TauheedAlamgir/Autonomous-Snowplow/README.md

# Autonomous Snowplow Robot
Project for SYSC 4805 – Carleton University

Overview:
This project focuses on developing an autonomous snowplow robot that detects obstacles, follows boundaries, and clears cube-shaped objects simulating snow. It combines sensor integration, movement control, and real-time communication using Arduino microcontrollers.

Features:
- Obstacle detection (Ultrasonic, ToF sensors)
- Line following using IR sensors
- PID-based movement control
- Custom 3D-printed plow design
- Integrated testing for speed, navigation, and obstacle avoidance

Hardware & Software:
- Microcontrollers: Arduino DUE, Arduino Nano Every
- Sensors: Ultrasonic, ToF, IMU, Line Follower
- Language: C/C++ (Arduino)
- Tools: AutoCAD, Arduino IDE

Files:

         SYSC4805_L3_Project_Proposal_Group5.pdf   – Project proposal
  
         SYSC4805_L3_ProgressReport_Group5-2.pdf   – Progress report
  
         SYSC4805_L3_FinalReport_Group5.pdf        – Final report
  
         PlowDesign1.jpg / PlowDesign2.jpg / PlowDesign3.jpg – CAD plow designs
  
         PlowDimensions.pdf                         – Plow dimensions
  
         VMA330UnitTest.ino                         – Obstacle detection test
  
         line_follower.cpp                          – Line-following algorithm

Team Members:
  Ahmed Ali, Brendan Kennedy, Duncan MacLeod, Tauheed Alamgir
