TauheedAlamgir/Autonomous-Snowplow/PlowDesign2.jpg

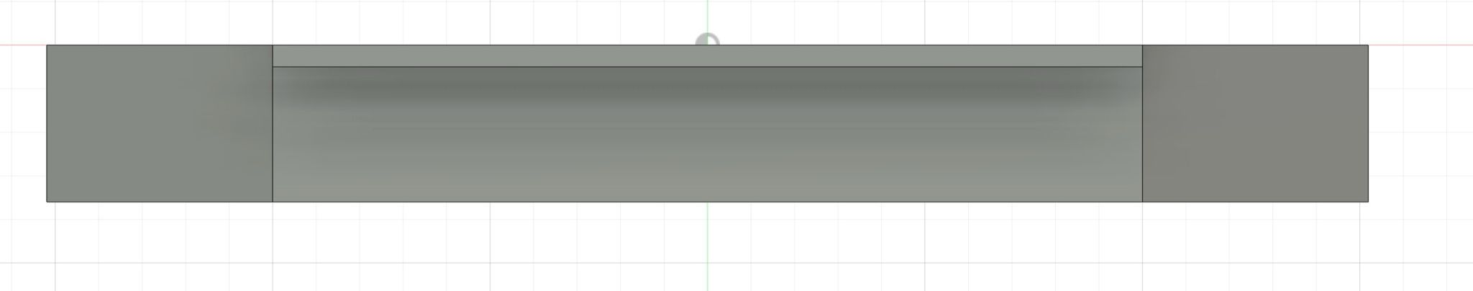
PlowDesign2.jpg
