TauheedAlamgir/Autonomous-Snowplow/PlowDimensions.pdf

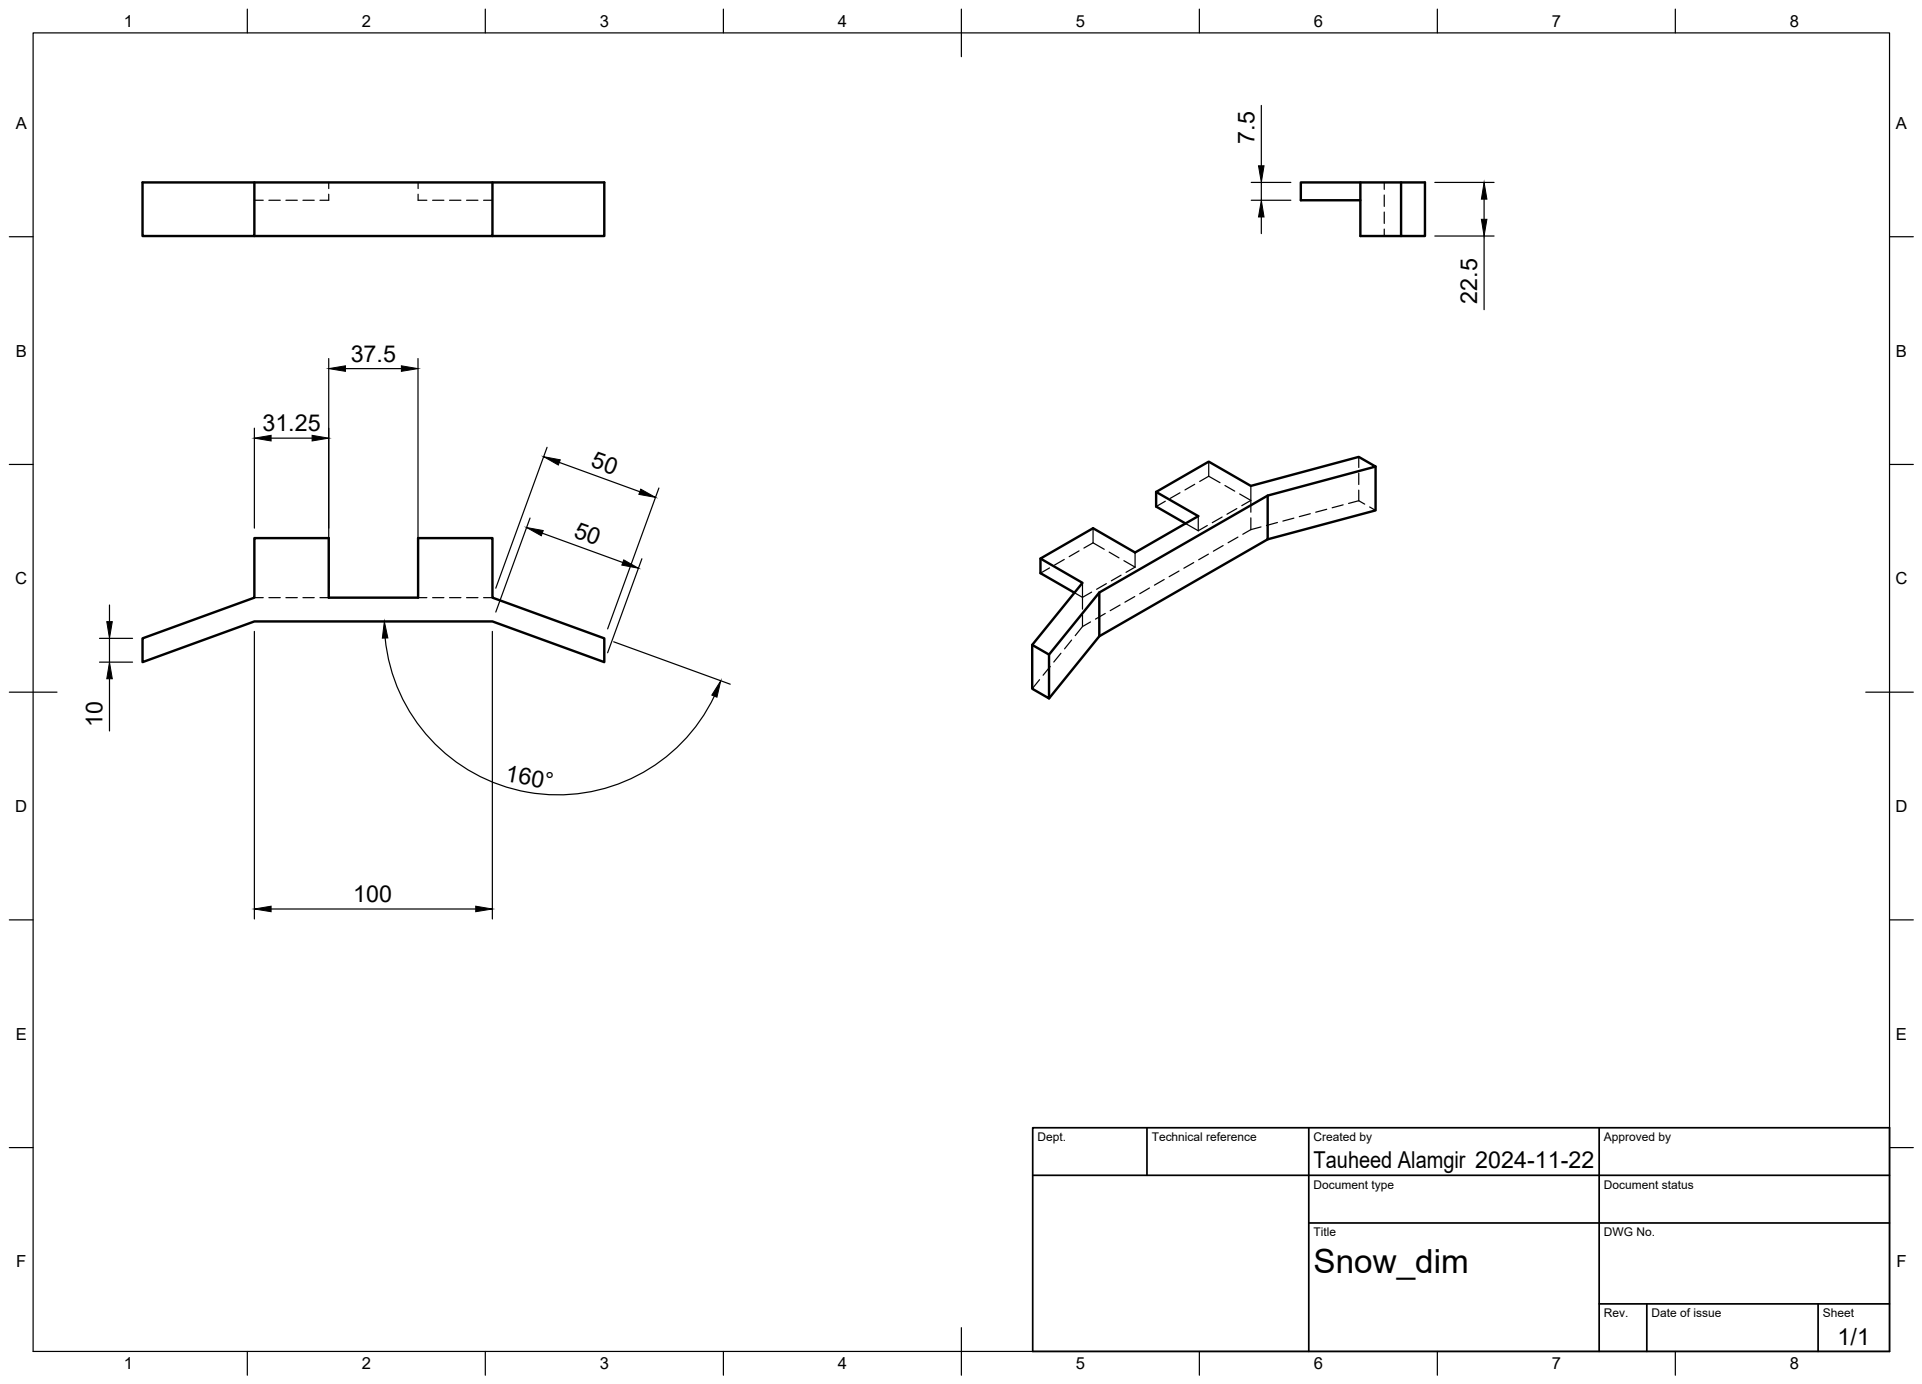
[picture p47: page 1]
Title; DWG No.; Rev.; Date of issue; Sheet

Dept. | Technical reference | Created by Tauheed Alamgir 2024-11-22 | Approved by

Document type | Document status
